mattvenn/solar-lora/pcb/schematic.pdf

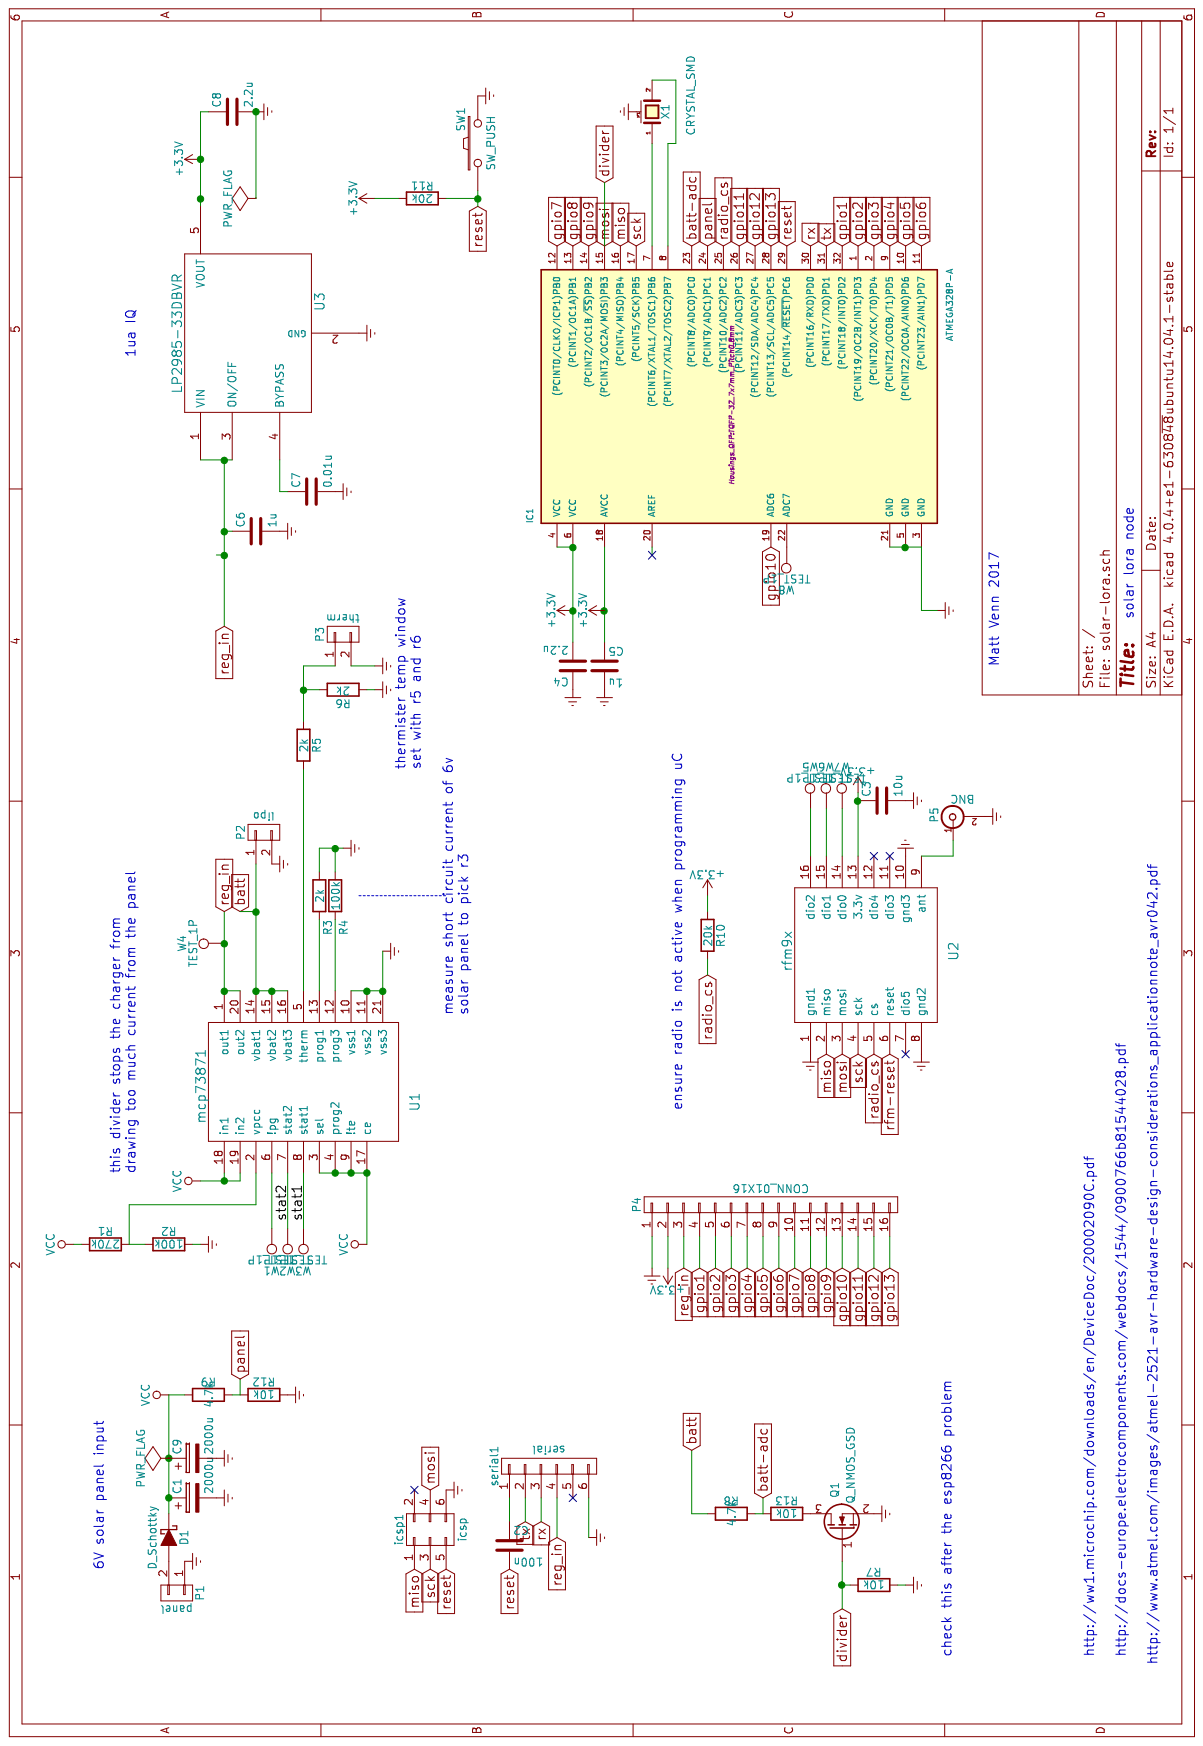
[picture p1: page 1]
