mattvenn/solar-lora/pcb/solar-lora.kicad_pcb

## KiCad design pcb/solar-lora.kicad_pcb (2017-01-31)

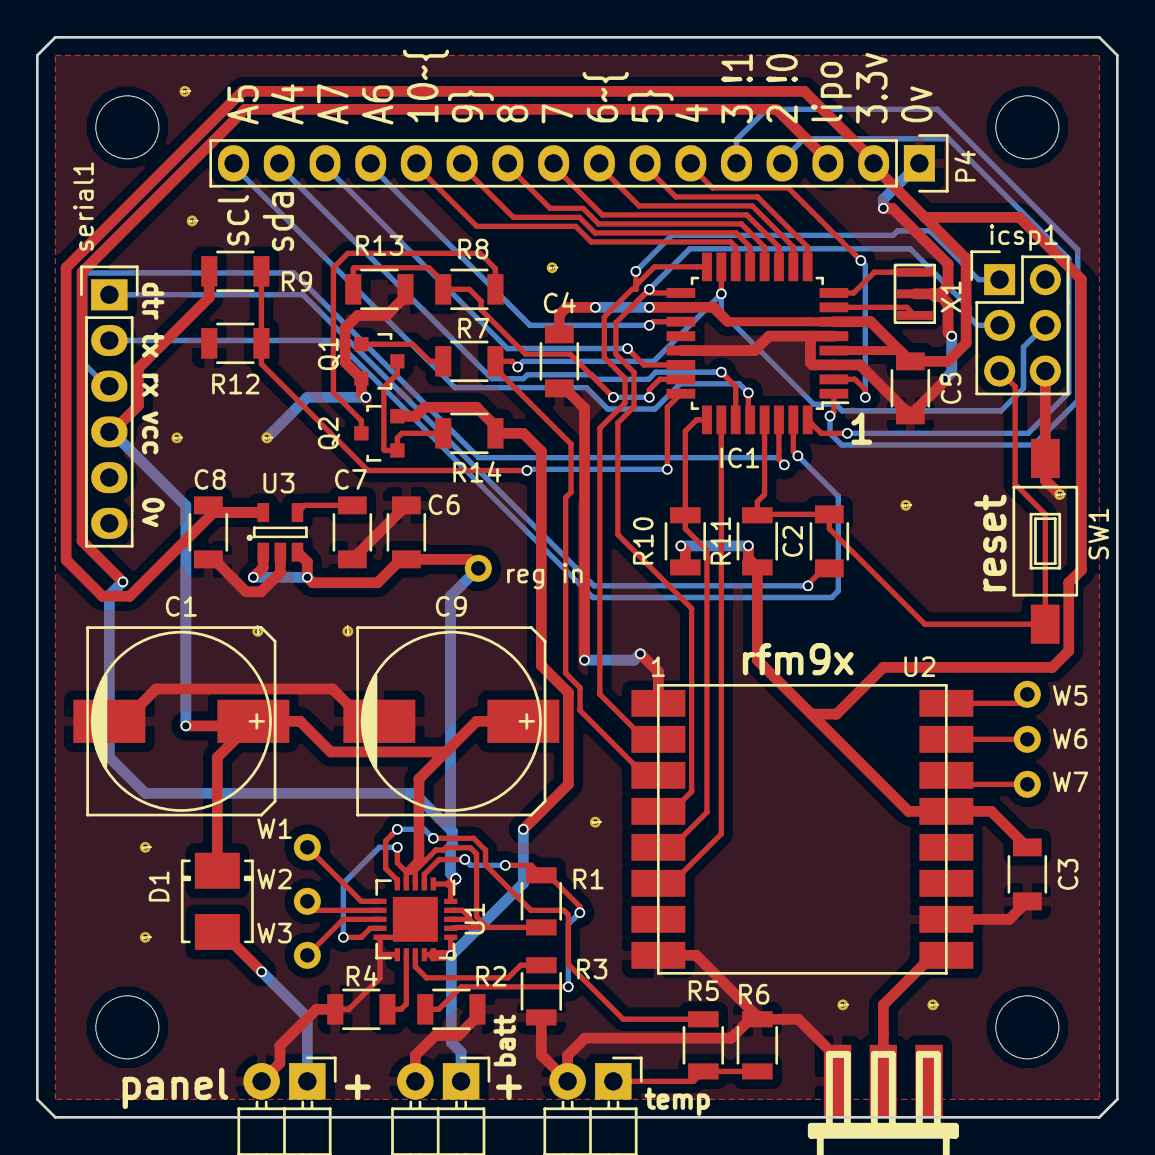
[picture p2: board solar-lora.kicad_pcb from above]

Board: 2 copper layers, 60.0 x 60.0 mm, 46 parts (0 on the bottom side), 48 nets.

Parts:
C1, C9: 2000u; c_elec_10x10
C2: 100n; C_1206
C3: 10u; C_1206
C4, C8: 2.2u; C_1206
C5, C6: 1u; C_1206
C7: 0.01u; C_1206
D1: D_Schottky; DO-214BA
IC1: ATMEGA328P-A; TQFP-32_7x7mm_Pitch0.8mm
P1: panel; Pin_Header_Angled_1x02
P2: lipo; Pin_Header_Angled_1x02
P3: therm; Pin_Header_Angled_1x02
P4: CONN_01X16; Pin_Header_Straight_1x16
P5: BNC; CON-SMA-EDGE
Q1: BC849; SOT-23
Q2: Q_PMOS_GSD; SOT-23
R1: 270k; R_1206
R2, R4: 100k; R_1206
R3, R5, R6: 2k; R_1206
R7, R12, R13, R14: 10k; R_1206
R8, R9: 4.7k; R_1206
R10, R11: 20k; R_1206
SW1: SW_PUSH; SW_SPST_FSMSM
U1: mcp73871; QFN-20-1EP_4x4mm_Pitch0.5mm
U2: rfm9x; rf9x
U3: LP2985-33DBVR; SOT-23-5
W1, W2, W3, W5, W6, W7: TEST_1P; Measurement_Point_Round-TH_Small
X1: CRYSTAL_SMD; cstce-v
icsp1: icsp; Pin_Header_Straight_2x03
reg in: TEST_1P; Measurement_Point_Round-TH_Small
serial1: serial; Pin_Header_Straight_1x06

Connections:
+3V3: C3.1, C4.2, C5.1, C8.1, IC1.4, IC1.6, IC1.18, P4.2, R10.1, R11.1, U2.13, U3.5
/stat1: U1.8, W3.1
/stat2: U1.7, W2.1
Earth: C1.2, C3.2, C4.1, C5.2, C6.2, C7.2, C8.2, C9.2, IC1.3, IC1.5, IC1.21, P1.2, P2.2, P3.2, P4.1, P5.2, Q1.2, R2.2, R3.1, R4.1, R6.1, R12.2, R13.2, SW1.2, U1.10, U1.11, U1.21, U2.1, U2.8, U2.10, U3.2, X1.3, icsp1.6, serial1.6
unnamed: C2.1, serial1.1
unnamed: C7.1, U3.4
unnamed: D1.2, P1.1
unnamed: IC1.7, X1.1
unnamed: IC1.8, X1.2
unnamed: P3.1, R5.1, R6.2
unnamed: P5.1, U2.9
unnamed: Q1.1, R7.1
unnamed: Q1.3, Q2.1, R14.1
unnamed: Q2.3, R8.1
unnamed: R1.2, R2.1, U1.2
unnamed: R3.2, U1.13
unnamed: R4.2, U1.12
unnamed: R5.2, U1.5
unnamed: U1.6, W1.1
unnamed: U2.14, W7.1
unnamed: U2.15, W6.1
unnamed: U2.16, W5.1
VCC: C1.1, C9.1, D1.1, R1.1, R9.1, U1.3, U1.4, U1.9, U1.17, U1.18, U1.19, serial1.4
batt: P2.1, Q2.2, R14.2, U1.14, U1.15, U1.16
batt-adc: IC1.23, R8.2, R13.1
divider: IC1.15, R7.2, U2.3, icsp1.4
gpio1: IC1.32, P4.4
gpio2: IC1.1, P4.5
gpio3: IC1.2, P4.6
gpio4: IC1.9, P4.7
gpio5: IC1.10, P4.8
gpio6: IC1.11, P4.9
gpio7: IC1.12, P4.10
gpio8: IC1.13, P4.11
gpio9: IC1.14, P4.12
gpio10: IC1.19, P4.13
gpio11: IC1.22, P4.14
gpio12: IC1.27, P4.15
gpio13: IC1.28, P4.16
miso: IC1.16, U2.2, icsp1.1
panel: IC1.24, R9.2, R12.1
radio_cs: IC1.25, R10.2, U2.5
reg_in: C6.1, P4.3, U1.1, U1.20, U3.1, U3.3, reg in.1
reset: C2.2, IC1.29, R11.2, SW1.1, icsp1.5
rfm-reset: IC1.26, U2.6
rx: IC1.30, serial1.3
sck: IC1.17, U2.4, icsp1.3
tx: IC1.31, serial1.2
