mattvenn/solar-lora/(commit log)

2017-01-20 Link to adafruit analysis of lipo charger
    [solar-lora.sch]
2017-01-20 schematic checked and first layout
    [solar-lora.kicad_pcb, solar-lora.sch]
2017-01-31 sent to fab and resistor calcs for charger
    [solar-lora.kicad_pcb, solar-lora.sch]
2017-02-07 working test sending panel and battery voltage
2017-02-18 packet count
    [solar-lora.sch]
